MrBlonkie/knex-tilt-coaster/README.md

Prototype video: https://www.youtube.com/watch?v=h58qSegKc38

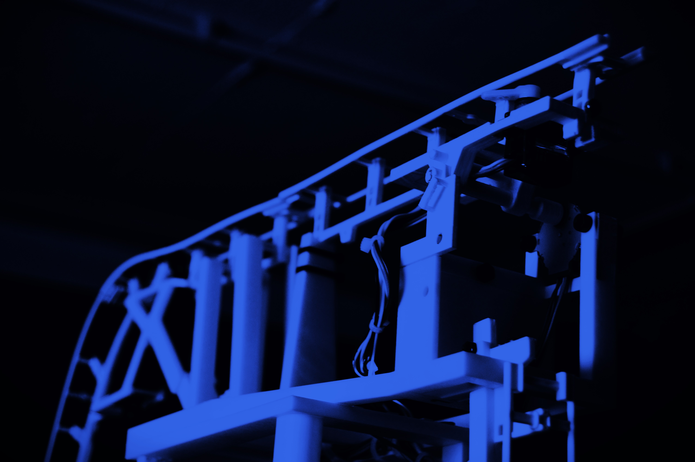
[picture p1: pictures/blue-edit-DSC_0136.JPG]
