MrBlonkie/knex-tilt-coaster/connection_docs/cable-management.pdf

Kabel-ID | Kleur | ESP(Model)/PIN
hallSensorExitStation-1 | green | 5V
hallSensorExitStation-2 | white | GND
hallSensorExitStation-3 | red | GIOP 35
hallSensorStartPosition-1 | green | 5V
hallSensorStartPosition-2 | white | GND
hallSensorStartPosition-3 | red | GIOP 32
hallSensorEnterStation-1 | green | 5V
hallSensorEnterStation-2 | white | GND
hallSensorEnterStation-3 | red | GIOP 34
stationGateServo-oe | red | 5V
stationGateServo-rd | blue | GND
stationGateServo-bn | yellow | GIOP 15
hallSensorBottomLifthill-1 | green | 5V
hallSensorBottomLifthill-2 | white | GND
hallSensorBottomLifthill-3 | red | GIOP 25
ledExitStation | red | 5V
ledExitStation | green | GIOP 21
ledExitStation | blue | GND
mac address: F8:B3:B7:33:41:FC | 192.168.0.50

station

Kabel-ID | Kleur | Driver | ESP(Model)/PIN
stationStepper-be | connector | LN1 | GIOP 18
stationStepper-pk-we-pk | connector | LN2 | GIOP 19
stationStepper-yw | connector | LN3 | GIOP 22
stationStepper-oe-gn-oe | connector | LN4 | GIOP 23
stationStepper-rd | connector
lifthillStepper | driver-Enable | / | GIOP 14
lifthillStepper | driver-Step | / | GIOP 27
lifthillStepper | driver-Direction | / | GIOP 26
enterServo-oe | purple | GPIO 25
enterServo-rd | brown | 5V
enter-bn | white | GND

station

Kabel-ID | Kleur | ESP(Model)/PIN
hallSensorOnTiltdrop-1 | black | 5V
hallSensorOnTiltdrop-2 | white | GND
hallSensorOnTiltdrop-3 | yellow | GIOP 34
hallSensorTiltdropClosed-1 | black | 5V
hallSensorTiltdropClosed-2 | white | GND
hallSensorTiltdropClosed-3 | red | GIOP 26
hallSensorOffTiltdrop-1 | black | 5V
hallSensorOffTiltdrop-2 | white | GND
hallSensorOffTiltdrop-3 | blue | GIOP 27
hallSensorTiltdropOpen-1 | black | 5V
hallSensorTiltdropOpen-2 | white | GND
hallSensorTiltdropOpen-3 | green | GIOP 32
ledLifthillTower | red | 5V
ledLifthillTower | green | GIOP 14
ledLifthillTower | blue | GND
ledTilt | red | 5V
ledTilt | green | GIOP 13
ledTilt | blue | GND
ledDrop | red | 5V
ledDrop | green | GIOP 12
ledDrop | blue | GND

tilt_drop

Kabel-ID | Kleur | Driver | ESP(Model)/PIN
tiltdropStepper-be | connector | LN1 | GIOP 18
tiltdropStepper-pk-we-pk | connector | LN2 | GIOP 19
tiltdropStepper-yw | connector | LN3 | GIOP 22
tiltdropStepper-oe-gn-oe | connector | LN4 | GIOP 23
tiltdropStepper-rd | connector
releaseServo-oe | yellow | GPIO 33
releaseServo-rd | red | 5V
releaseServo-bn | black | GND
mac address ESP2/Tilt_Drop | E8:31:CD:AE:87:4C | 192.168.0.51

tilt_drop

Kabel-ID | Kleur | ESP(Model)/PIN
hallSensorStationConnect-1 | black | 5V
hallSensorStationConnect-2 | blue | GND
hallSensorStationConnect-3 | green | GIOP 27
hallSensorBrakeConnect-1 | yellow | 5V
hallSensorBrakeConnect-2 | blue | GND
hallSensorBrakeConnect-3 | white/grey | GIOP 26
brakesServo-oe | yellow | GPIO 25
brakesServo-rd | red | 5V
brakesServo-bn | black | GND

brakes

Kabel-ID | Kleur | ESP(Model)/PIN
hallSensorStationConnect-1 | black | 5V
hallSensorStationConnect-2 | blue | GND
hallSensorStationConnect-3 | green | GIOP 27
hallSensorBrakeConnect-1 | yellow | 5V
hallSensorBrakeConnect-2 | blue | GND
hallSensorBrakeConnect-3 | white/grey | GIOP 26
hallSensorMiddle-1 | black | 5V
hallSensorMiddle-2 | blue | GND
hallSensorMiddle-3 | green | GIOP 25
hallSensorOnSwitchtrack-1 | black | 5V
hallSensorOnSwitchtrack-2 | blue | GND
hallSensorOnSwitchtrack-3 | green | GIOP 32
releaseServo-oe | yellow | GPIO 33
releaseServo-rd | black | 5V
releaseServo-bn | white | GND

switch_track

Kabel-ID | Kleur | Driver | ESP(Model)/PIN
RotatingStepper-be | connector | LN1 | GIOP 19
RotatingStepper-pk-bk-pk | connector | LN2 | GIOP 21
RotatingStepper-yw | connector | LN3 | GIOP 22
RotatingStepper-oe-gn-oe | connector | LN4 | GIOP 23
RotatingStepper-rd | connector
TiltingStepper-be | connector | LN1 | GIOP 14
TiltingStepper-pk-bk-pk | connector | LN2 | GIOP 13
TiltingStepper-yw | connector | LN3 | GIOP 15
TiltingStepper-oe-gn-oe | connector | LN4 | GIOP 18
TiltingStepper-rd | connector

switch_track
