MrBlonkie/knex-tilt-coaster/pictures/tiltdrop_WIP.jpg

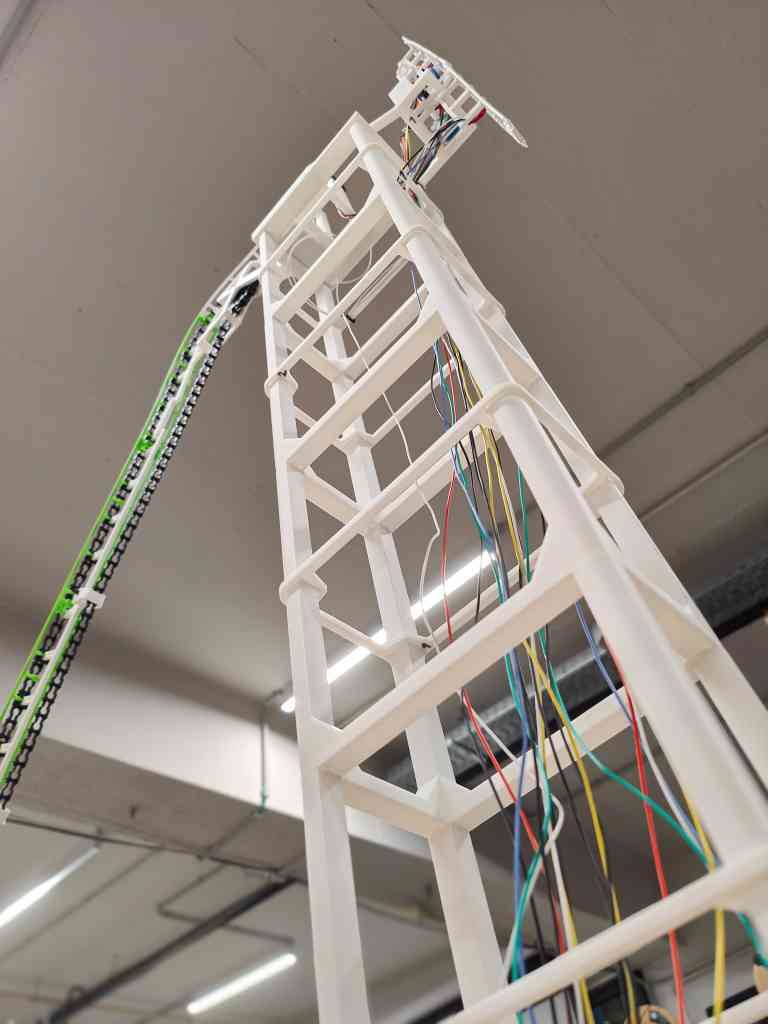
pictures/tiltdrop_WIP.jpg
