MrBlonkie/knex-tilt-coaster/connection_docs/brakes-dvv-schema.pdf

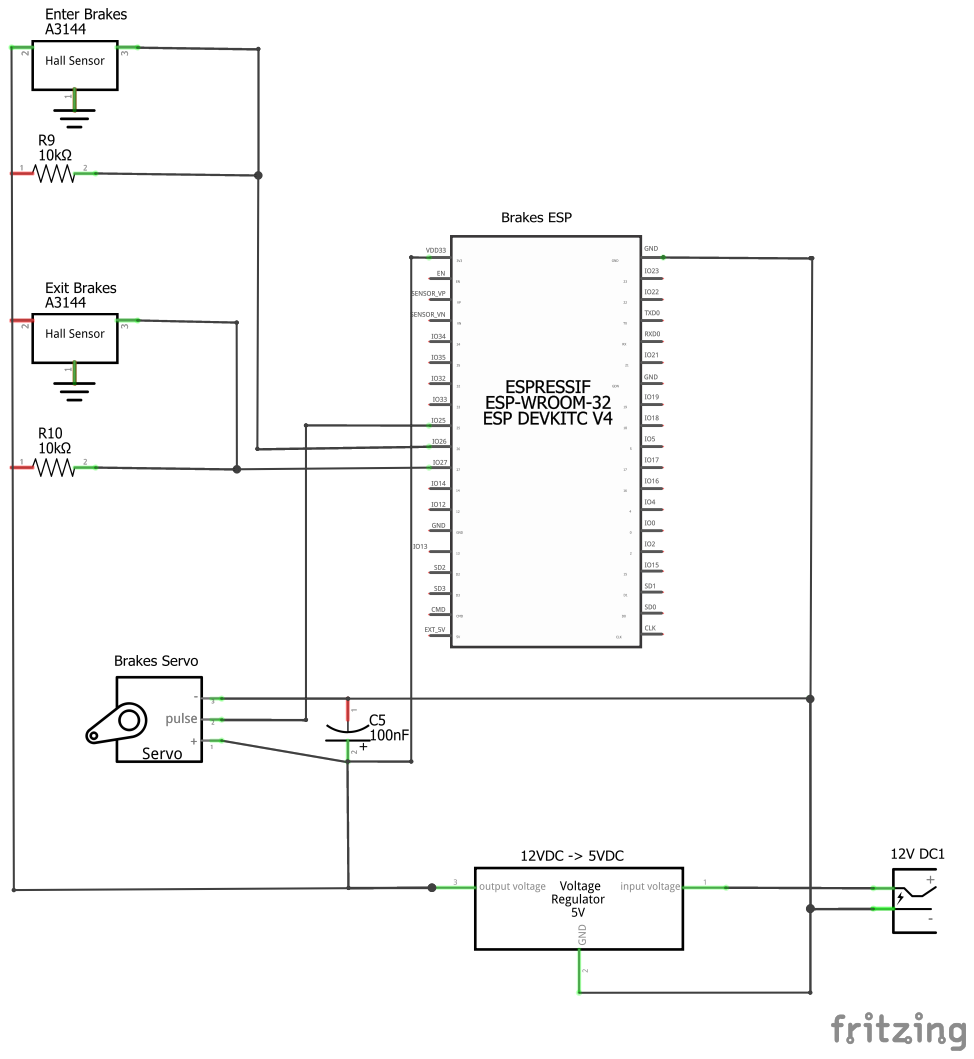
[picture p3: page 1]
