MrBlonkie/knex-tilt-coaster/connection_docs/station-dvv-schema.pdf

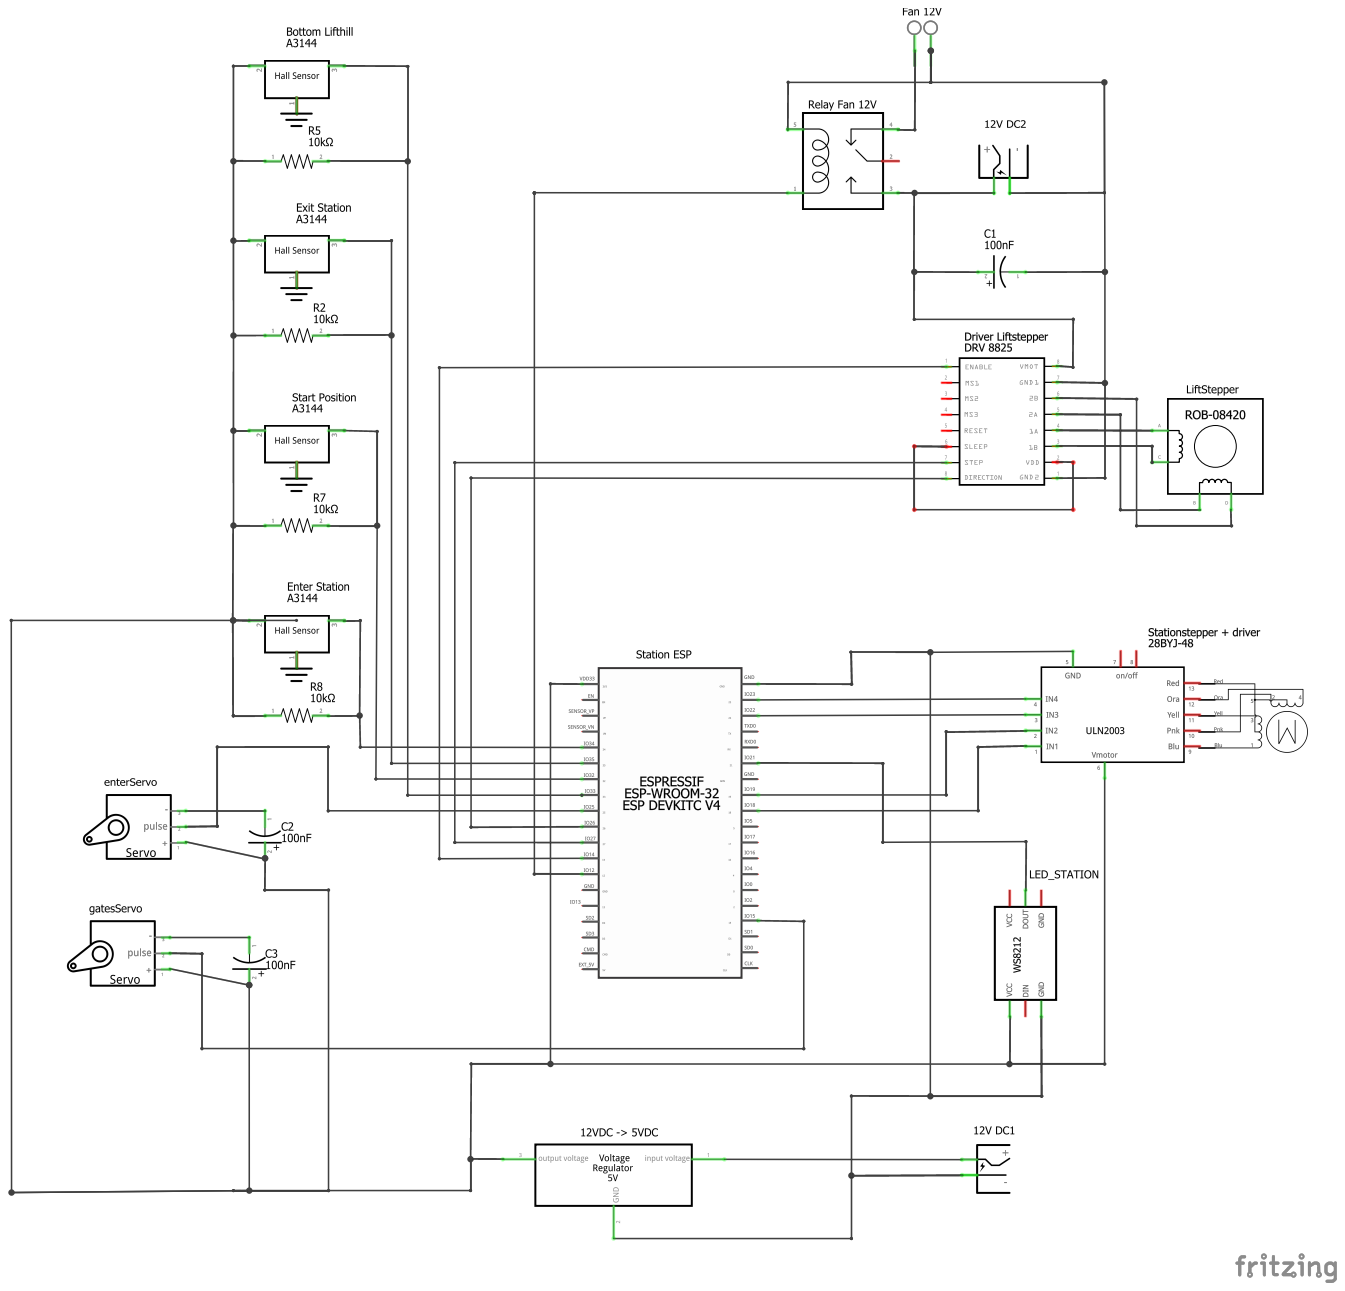
[picture p4: page 1]
