MrBlonkie/knex-tilt-coaster/connection_docs/switchtrack-dvv-schema.pdf

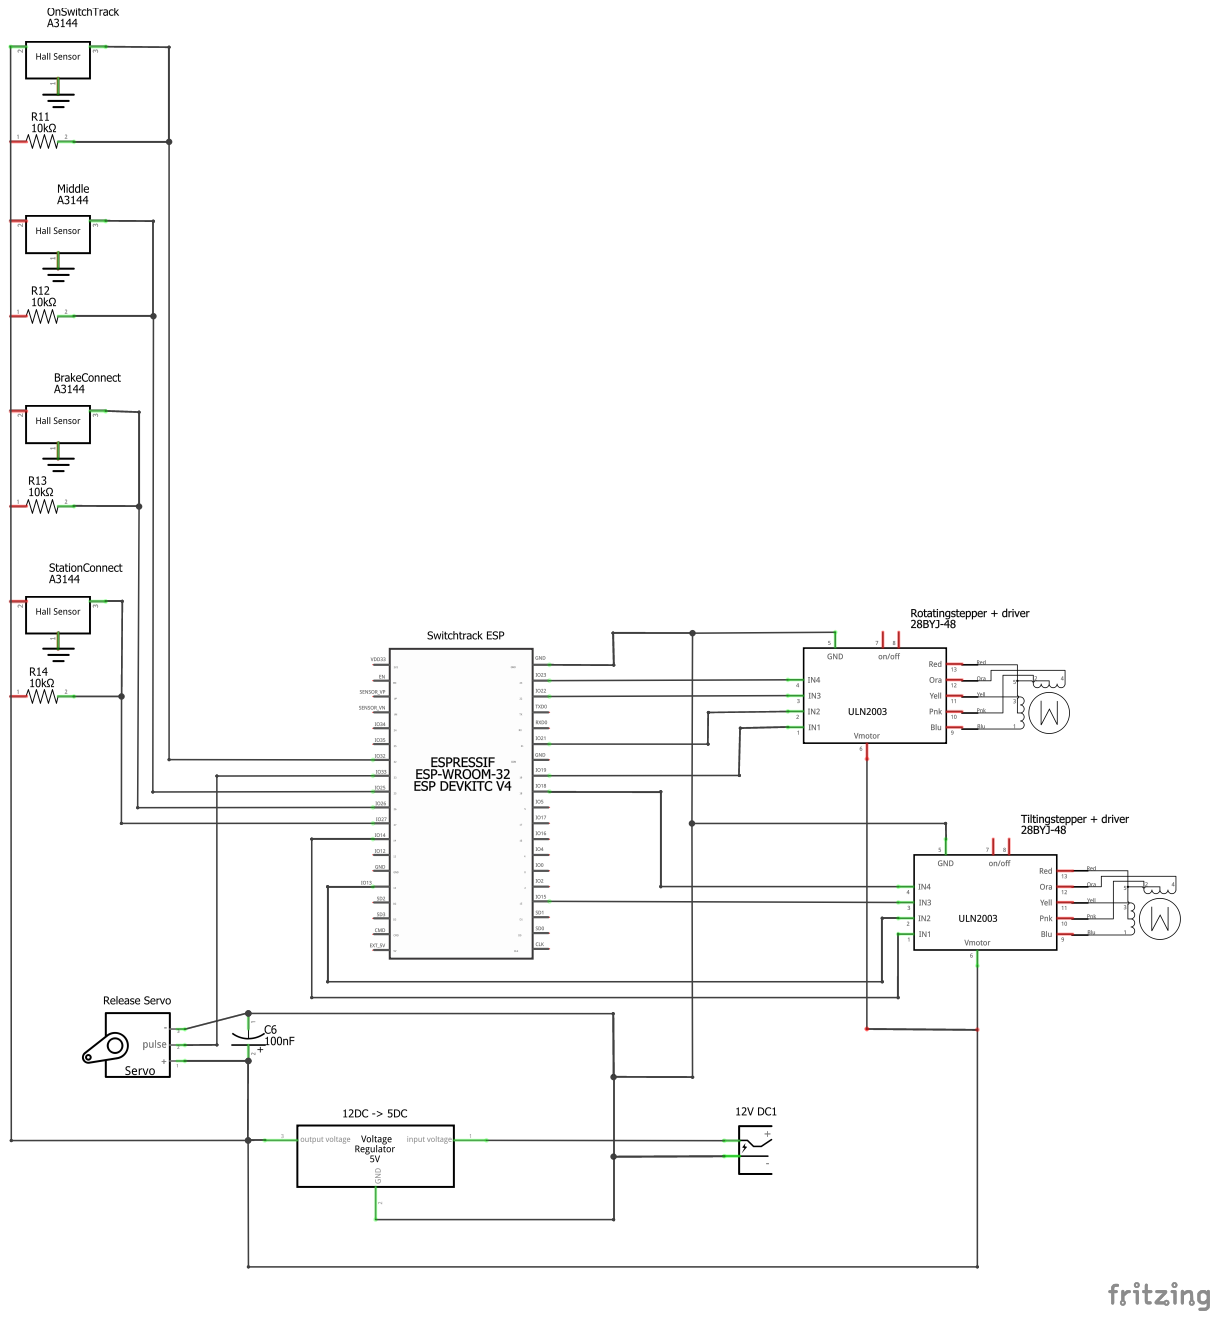
[picture p5: page 1]
