MrBlonkie/knex-tilt-coaster/connection_docs/tiltdrop-dvv-schema.pdf

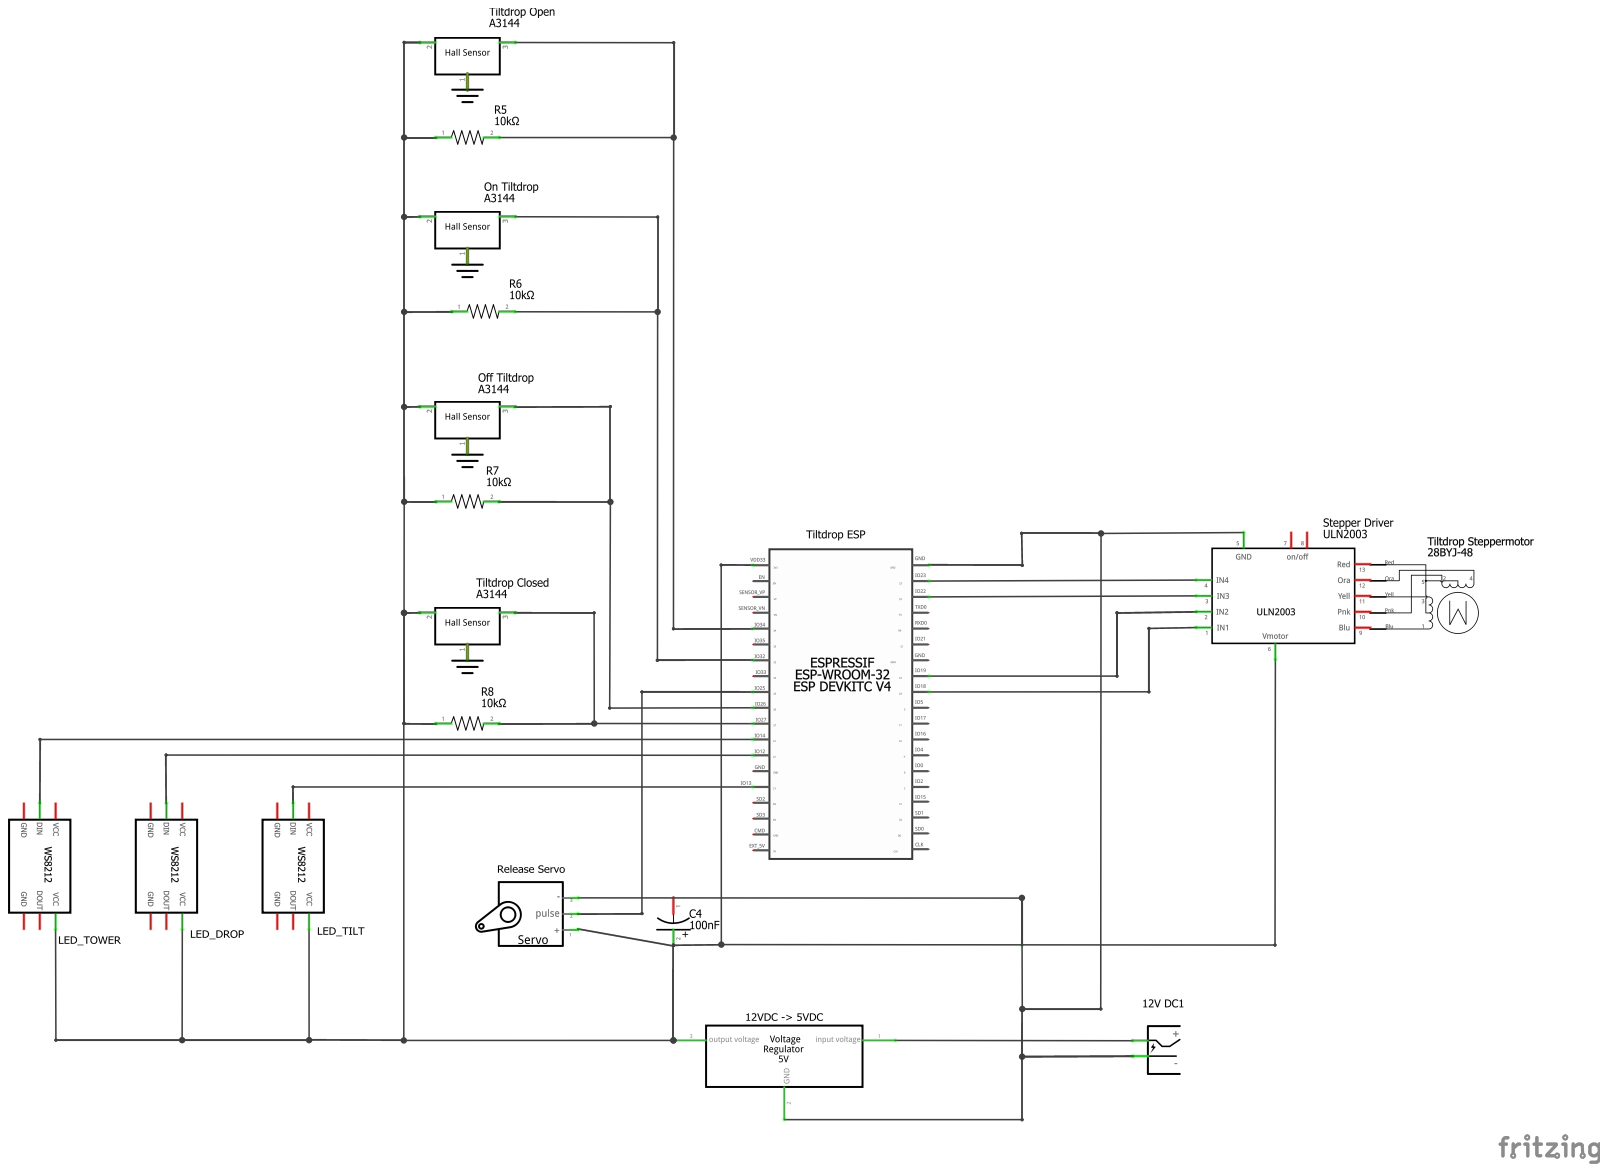
[picture p6: page 1]
