MrBlonkie/knex-tilt-coaster/(list of files, drawings)

Other design files:
connection_docs/station-electric-scheme.fzz
connection_docs/tiltdrop-electric-scheme.fzz
