MrBlonkie/knex-tilt-coaster/(commit log)

2025-03-06 hall sensor logic, started on station logic
2025-03-12 added steppermotor for lifthill
2025-05-13 tilt track motors
    stepper and servo motor for tilt track
2025-05-20 progress day1&2
    [Arduino_Kabelbeheer_Template.xlsx]
2025-05-21 tiltdrop sequence
    [Arduino_Kabelbeheer_Template.xlsx]
2025-05-21 addedd .gitignore
    [Arduino_Kabelbeheer_Template.xlsx]
2025-05-26 progress 23/05
    [Arduino_Kabelbeheer_Template.xlsx]
2025-05-26 digital electric schemes
    [station-electric-scheme.fzz, tiltdrop-electric-scheme.fzz]
2025-05-26 corrected mistakes schemes
    [station-electric-scheme.fzz, tiltdrop-electric-scheme.fzz]
2025-06-13 started on maintenance track
    [Arduino_Kabelbeheer_Template.xlsx]
2025-06-25 updated documentation
    [Arduino_Kabelbeheer_Template.xlsx]
2025-10-22 removed credentails out repo/ added LED's
    [Arduino_Kabelbeheer_Template.xlsx]
2025-10-22 added LED effects on tiltdrop
2025-11-04 added MQTT code
    [Arduino_Kabelbeheer_Template.xlsx]
2025-11-07 tilttrackStepper now stops moving based on sensor data
2025-11-13 added switchTrackEsp
2025-11-20 liftStepper manual mode now works with new stepper
2025-11-21 added relay that controls fan
2025-11-21 full auto logic now working
    still a stationstepper bug, need to fix asap
    [main.cpp]
2025-11-25 fixed stationstepper stutter bug
    [main.cpp]
2025-11-26 added switchtrak MQTT connection with website
2025-12-02 added leds to tiltdrop, full auto and manual works with station and tiltdrop
    [Arduino_Kabelbeheer_Template.xlsx]
2025-12-03 tiltdrop sensordata live updates on layout map
2025-12-05 added switchtrack esp-web comms
2025-12-09 made servo non blocking
2025-12-10 fixed tiltdrop_closed spam bug
    [main.cpp]
2025-12-16 update connection doc
    [Arduino_Kabelbeheer_Template.xlsx]
2025-12-16 finetuned motor controls switchtrack
2026-01-13 added Servo for entering station
    to make sure it enters station 100% of the time, it does now
2026-01-13 tweaked motor values for consistent moving to brakes
2026-01-14 update connection docs
    [Arduino_Kabelbeheer_Template.xlsx]
2026-01-14 fixed station motor bug (did not move after stopping in auto mode)
    [main.cpp]
2026-01-15 init brakesEsp, connect with website, basic sensor data
2026-02-06 added ledboard ESP, and basic code for displaying text per block
    [Arduino_Kabelbeheer_Template.xlsx]
2026-02-13 added brakes logic
2026-02-26 updated values for new guiding rail
2026-02-26 again tweaking for guiding rail
2026-06-01 updated docs
    [Arduino_Kabelbeheer_Template.xlsx, cable-management.xlsx, station-electric-scheme.fzz, tiltdrop-electric-scheme.fzz]
2026-06-03 redesign switchtrack movement
2026-06-04 fixed JSON structure mqtt data
    [main.cpp]
2026-06-04 added tweaking values for every movement required in switchtrack
2026-06-04 fixed reset bug brakes
    [main.cpp]
2026-06-04 fixed lifthill estop bug
    [main.cpp]
2026-06-04 fixed stationmotor not stopping on gates bug
    [main.cpp]
